ayushsagar/HDMI2USB-vmodserial/mechanical/VHDCI mating distance.jpg

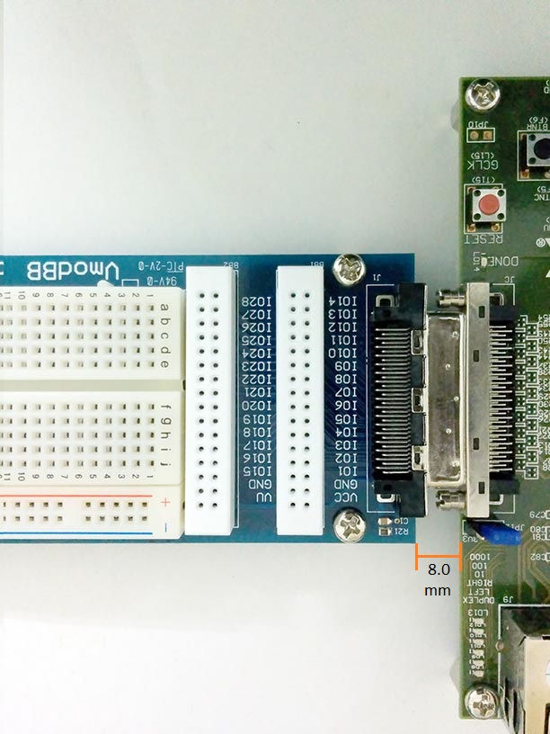
mechanical/VHDCI mating distance.jpg
