ayushsagar/HDMI2USB-vmodserial/boards/Motherboard/Motherboard.kicad_pcb

## KiCad design boards/Motherboard/Motherboard.kicad_pcb (2014-07-07)

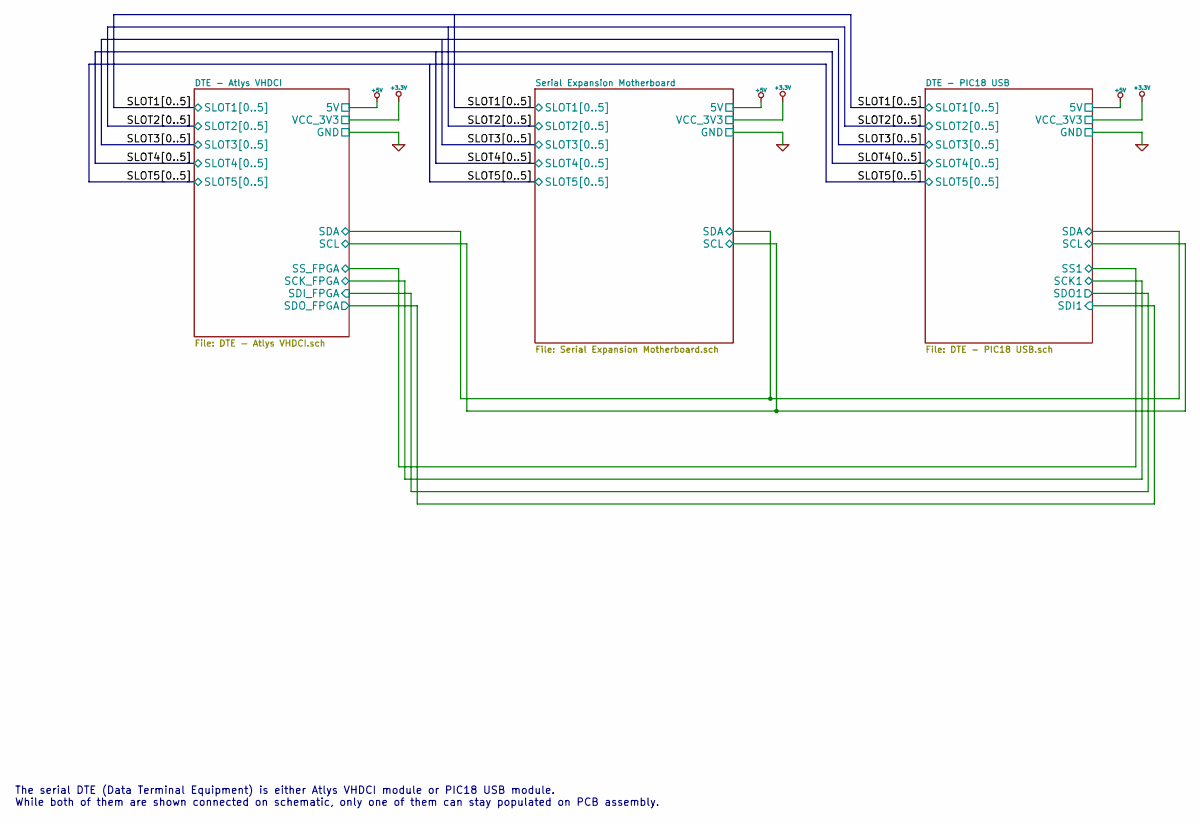
[picture p2: schematic Motherboard.sch, Serial Expansion Module and DTE interface]

Notes on the sheet:
The serial DTE (Data Terminal Equipment) is either Atlys VHDCI module or PIC18 USB module. While both of them are shown connected on schematic, only one of them can stay populated on PCB assembly.

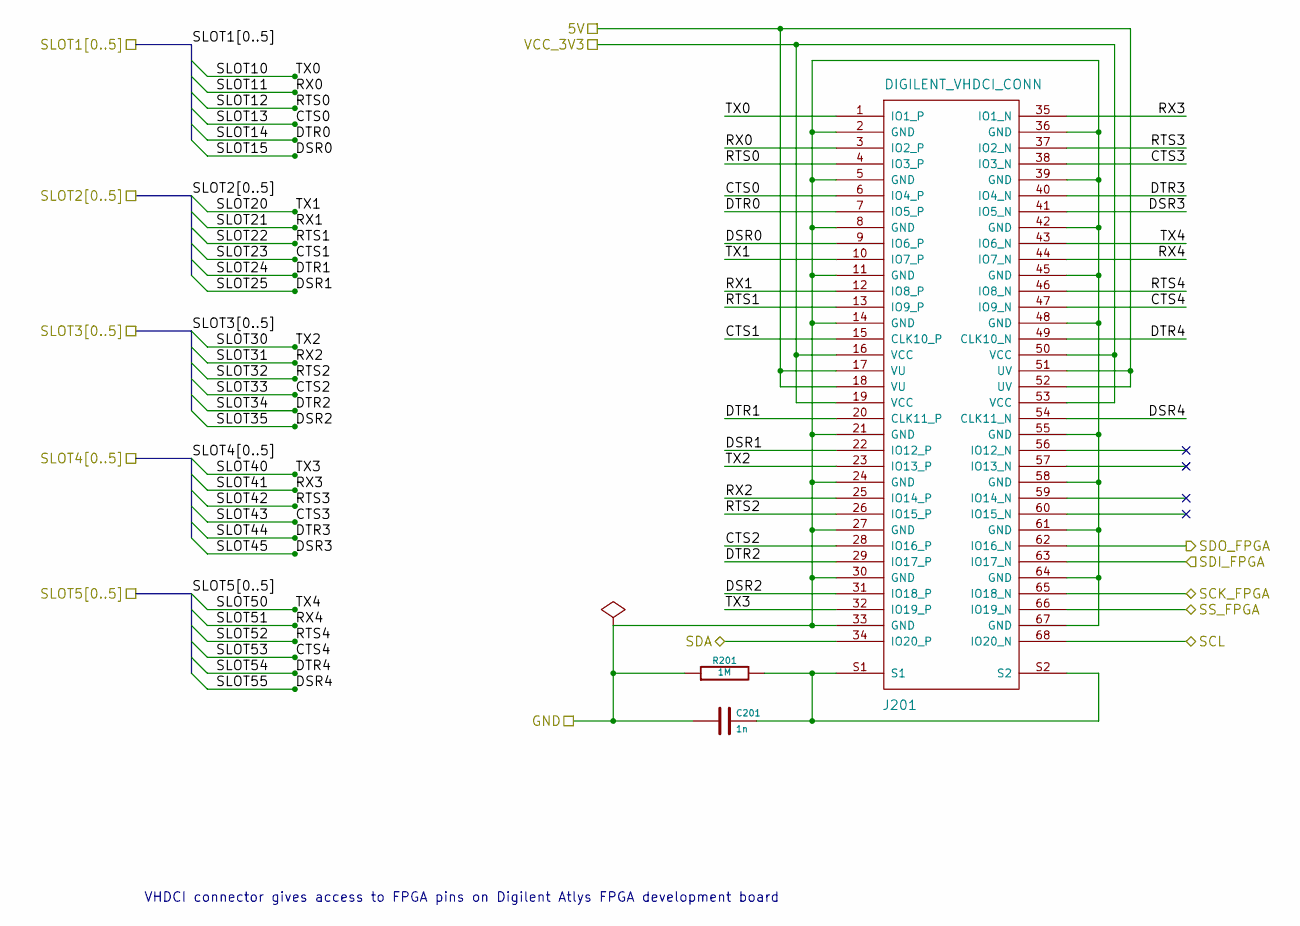
[picture p3: schematic DTE - Atlys VHDCI.sch]

Parts:
C201: 1n
J201: DIGILENT_VHDCI_CONN
R201: 1M

Connections:
+3.3V: J201.16 (VCC), J201.19 (VCC), J201.50 (VCC), J201.53 (VCC); also elsewhere on the board
+5V: J201.17 (VU), J201.18 (VU), J201.51 (UV), J201.52 (UV); also elsewhere on the board
/DTE - Atlys VHDCI/SCL: J201.68 (IO20_N); also elsewhere on the board
/DTE - Atlys VHDCI/SDA: J201.34 (IO20_P); also elsewhere on the board
/DTE - Atlys VHDCI/SDI_FPGA: J201.63 (IO17_N); also elsewhere on the board
/DTE - PIC18 USB/SCK1: J201.65 (IO18_N); also elsewhere on the board
/DTE - PIC18 USB/SDI1: J201.62 (IO16_N); also elsewhere on the board
/DTE - PIC18 USB/SS1: J201.66 (IO19_N); also elsewhere on the board
/Serial Expansion Motherboard/Data isolation/IN0_A: J201.1 (IO1_P); also elsewhere on the board
/Serial Expansion Motherboard/Data isolation/IN1_A: J201.4 (IO3_P); also elsewhere on the board
/Serial Expansion Motherboard/Data isolation/IN2_A: J201.7 (IO5_P); also elsewhere on the board
/Serial Expansion Motherboard/Data isolation/IN3_A: J201.10 (IO7_P); also elsewhere on the board
/Serial Expansion Motherboard/Data isolation/IN4_A: J201.13 (IO9_P); also elsewhere on the board
/Serial Expansion Motherboard/Data isolation/IN5_A: J201.20 (CLK11_P); also elsewhere on the board
/Serial Expansion Motherboard/Data isolation/IN6_A: J201.23 (IO13_P); also elsewhere on the board
/Serial Expansion Motherboard/Data isolation/IN7_A: J201.26 (IO15_P); also elsewhere on the board
/Serial Expansion Motherboard/Data isolation/IN8_A: J201.29 (IO17_P); also elsewhere on the board
/Serial Expansion Motherboard/Data isolation/IN9_A: J201.32 (IO19_P); also elsewhere on the board
/Serial Expansion Motherboard/Data isolation/IN10_A: J201.37 (IO2_N); also elsewhere on the board
/Serial Expansion Motherboard/Data isolation/IN11_A: J201.40 (IO4_N); also elsewhere on the board
/Serial Expansion Motherboard/Data isolation/IN12_A: J201.43 (IO6_N); also elsewhere on the board
/Serial Expansion Motherboard/Data isolation/IN13_A: J201.46 (IO8_N); also elsewhere on the board
/Serial Expansion Motherboard/Data isolation/IN14_A: J201.49 (CLK10_N); also elsewhere on the board
/Serial Expansion Motherboard/Data isolation/OUT0_A: J201.3 (IO2_P); also elsewhere on the board
/Serial Expansion Motherboard/Data isolation/OUT1_A: J201.6 (IO4_P); also elsewhere on the board
/Serial Expansion Motherboard/Data isolation/OUT2_A: J201.9 (IO6_P); also elsewhere on the board
/Serial Expansion Motherboard/Data isolation/OUT3_A: J201.12 (IO8_P); also elsewhere on the board
/Serial Expansion Motherboard/Data isolation/OUT4_A: J201.15 (CLK10_P); also elsewhere on the board
/Serial Expansion Motherboard/Data isolation/OUT5_A: J201.22 (IO12_P); also elsewhere on the board
/Serial Expansion Motherboard/Data isolation/OUT6_A: J201.25 (IO14_P); also elsewhere on the board
/Serial Expansion Motherboard/Data isolation/OUT7_A: J201.28 (IO16_P); also elsewhere on the board
/Serial Expansion Motherboard/Data isolation/OUT8_A: J201.31 (IO18_P); also elsewhere on the board
/Serial Expansion Motherboard/Data isolation/OUT9_A: J201.35 (IO1_N); also elsewhere on the board
/Serial Expansion Motherboard/Data isolation/OUT10_A: J201.38 (IO3_N); also elsewhere on the board
/Serial Expansion Motherboard/Data isolation/OUT11_A: J201.41 (IO5_N); also elsewhere on the board
/Serial Expansion Motherboard/Data isolation/OUT12_A: J201.44 (IO7_N); also elsewhere on the board
/Serial Expansion Motherboard/Data isolation/OUT13_A: J201.47 (IO9_N); also elsewhere on the board
/Serial Expansion Motherboard/Data isolation/OUT14_A: J201.54 (CLK11_N); also elsewhere on the board
GND: C201.1, J201.2 (GND), J201.5 (GND), J201.8 (GND), J201.11 (GND), J201.14 (GND), J201.21 (GND), J201.24 (GND), J201.27 (GND), J201.30 (GND), J201.33 (GND), J201.36 (GND), J201.39 (GND), J201.42 (GND), J201.45 (GND), J201.48 (GND), J201.55 (GND), J201.58 (GND), J201.61 (GND), J201.64 (GND), J201.67 (GND), R201.1; also elsewhere on the board
unnamed: C201.2, J201.S1, J201.S2, R201.2

Notes on the sheet:
VHDCI connector gives access to FPGA pins on Digilent Atlys FPGA development board

Schematic: Serial Expansion Motherboard.sch

Parts:
C401: 0.1u
R401, R402: 2.2k
R403: 50
U401: 24AA014

Connections:
+3.3V: R401.1, R402.1, R403.1; also elsewhere on the board
/DTE - Atlys VHDCI/SCL: R402.2, U401.5 (SDA); also elsewhere on the board
/DTE - Atlys VHDCI/SDA: R401.2, U401.6 (SCL); also elsewhere on the board
GND: C401.1, U401.1 (A0), U401.2 (A1), U401.3 (A2), U401.4 (GND), U401.7 (WP); also elsewhere on the board
unnamed: C401.2, R403.2, U401.8 (VCC)

Notes on the sheet:
Motherboard ID EEPROM address set to 0 (000) by shorting A0, A1 and A2 to ground.

Schematic: DTE - PIC18 USB.sch

Parts:
C613, C614: 22p
C615, C616, C618, C619, C620, C623: 0.1u
C617: 10u
C621: 4.7n
C622: 4.7u
D611, D612, D613: LED
DS11, DS12, DS21, DS22, DS31, DS32, DS41, DS42, DS51, DS52: LED
J601: USB
P601: ICSP
P602: SPI2
R619: 10K
R620, R621: 50
R640: 1M
R641: 0.47
R688, R689, R690: 680
R691: 0.10
RS11, RS12, RS21, RS22, RS31, RS32, RS41, RS42, RS51, RS52: 680
U607: PIC18F85J94
U608: AAT3221IGV-3.3-T1
X601: XTAL

Connections:
+3.3V: C616.1, C618.1, C619.1, C620.1, C623.1, P601.2, P602.1, R619.1, R691.2, U607.23 (VUSB3V3), U607.32 (VDD), U607.48 (VDD), U607.71 (VDD); also elsewhere on the board
+5V: C622.1, R641.2, U608.1 (IN), U608.3 (EN); also elsewhere on the board
/DTE - Atlys VHDCI/SCL: U607.44 (RC3/SCL1); also elsewhere on the board
/DTE - Atlys VHDCI/SDA: U607.45 (RC4/SDA1); also elsewhere on the board
/DTE - Atlys VHDCI/SDI_FPGA: U607.3 (RE1); also elsewhere on the board
/DTE - PIC18 USB/LED_P: R688.1, U607.72 (RD0)
/DTE - PIC18 USB/LED_Q: R689.1, U607.18 (RF2)
/DTE - PIC18 USB/LED_R: R690.1, U607.15 (RF5)
/DTE - PIC18 USB/PGC: P601.5, U607.52 (RB6/PGC)
/DTE - PIC18 USB/PGD: P601.4, U607.47 (RB7/PGD)
/DTE - PIC18 USB/SCK1: U607.6 (RG1); also elsewhere on the board
/DTE - PIC18 USB/SCK2_HEADER: P602.4, U607.7 (RG2)
/DTE - PIC18 USB/SDI1: U607.4 (RE0); also elsewhere on the board
/DTE - PIC18 USB/SDI2_HEADER: P602.3, U607.69 (RD1)
/DTE - PIC18 USB/SDO2_HEADER: P602.2, U607.10 (RG4)
/DTE - PIC18 USB/SLOT1_LED1: RS11.1, U607.36 (RC0)
/DTE - PIC18 USB/SLOT1_LED2: RS12.1, U607.35 (RC1)
/DTE - PIC18 USB/SLOT2_LED1: RS21.1, U607.43 (RC2)
/DTE - PIC18 USB/SLOT2_LED2: RS22.1, U607.46 (RC5)
/DTE - PIC18 USB/SLOT3_LED1: RS31.1, U607.37 (RC6)
/DTE - PIC18 USB/SLOT3_LED2: RS32.1, U607.38 (RC7)
/DTE - PIC18 USB/SLOT4_LED1: RS41.1, U607.14 (RF6)
/DTE - PIC18 USB/SLOT4_LED2: RS42.1, U607.13 (RF7)
/DTE - PIC18 USB/SLOT5_LED1: RS51.1, U607.20 (RH6)
/DTE - PIC18 USB/SLOT5_LED2: RS52.1, U607.19 (RH7)
/DTE - PIC18 USB/SS1: U607.5 (RG0); also elsewhere on the board
/DTE - PIC18 USB/SS2_HEADER: P602.5, U607.8 (RG3)
/Serial Expansion Motherboard/Data isolation/IN0_A: U607.28 (RA2); also elsewhere on the board
/Serial Expansion Motherboard/Data isolation/IN1_A: U607.34 (RA4); also elsewhere on the board
/Serial Expansion Motherboard/Data isolation/IN2_A: U607.30 (RA0); also elsewhere on the board
/Serial Expansion Motherboard/Data isolation/IN3_A: U607.55 (RB3); also elsewhere on the board
/Serial Expansion Motherboard/Data isolation/IN4_A: U607.54 (RB4); also elsewhere on the board
/Serial Expansion Motherboard/Data isolation/IN5_A: U607.58 (RB0); also elsewhere on the board
/Serial Expansion Motherboard/Data isolation/IN6_A: U607.65 (RD5/SDA2); also elsewhere on the board
/Serial Expansion Motherboard/Data isolation/IN7_A: U607.64 (RD6/SCL2); also elsewhere on the board
/Serial Expansion Motherboard/Data isolation/IN8_A: U607.68 (RD2); also elsewhere on the board
/Serial Expansion Motherboard/Data isolation/IN9_A: U607.75 (RE5); also elsewhere on the board
/Serial Expansion Motherboard/Data isolation/IN10_A: U607.74 (RE6); also elsewhere on the board
/Serial Expansion Motherboard/Data isolation/IN11_A: U607.78 (RE2); also elsewhere on the board
/Serial Expansion Motherboard/Data isolation/IN12_A: U607.1 (RH2); also elsewhere on the board
/Serial Expansion Motherboard/Data isolation/IN13_A: U607.22 (RH4); also elsewhere on the board
/Serial Expansion Motherboard/Data isolation/IN14_A: U607.79 (RH0); also elsewhere on the board
/Serial Expansion Motherboard/Data isolation/OUT0_A: U607.27 (RA3); also elsewhere on the board
/Serial Expansion Motherboard/Data isolation/OUT1_A: U607.33 (RA5); also elsewhere on the board
/Serial Expansion Motherboard/Data isolation/OUT2_A: U607.29 (RA1); also elsewhere on the board
/Serial Expansion Motherboard/Data isolation/OUT3_A: U607.56 (RB2); also elsewhere on the board
/Serial Expansion Motherboard/Data isolation/OUT4_A: U607.53 (RB5); also elsewhere on the board
/Serial Expansion Motherboard/Data isolation/OUT5_A: U607.57 (RB1); also elsewhere on the board
/Serial Expansion Motherboard/Data isolation/OUT6_A: U607.66 (RD4); also elsewhere on the board
/Serial Expansion Motherboard/Data isolation/OUT7_A: U607.63 (RD7); also elsewhere on the board
/Serial Expansion Motherboard/Data isolation/OUT8_A: U607.67 (RD3); also elsewhere on the board
/Serial Expansion Motherboard/Data isolation/OUT9_A: U607.76 (RE4); also elsewhere on the board
/Serial Expansion Motherboard/Data isolation/OUT10_A: U607.73 (RE7); also elsewhere on the board
/Serial Expansion Motherboard/Data isolation/OUT11_A: U607.77 (RE3); also elsewhere on the board
/Serial Expansion Motherboard/Data isolation/OUT12_A: U607.2 (RH3); also elsewhere on the board
/Serial Expansion Motherboard/Data isolation/OUT13_A: U607.21 (RH5); also elsewhere on the board
/Serial Expansion Motherboard/Data isolation/OUT14_A: U607.80 (RH1); also elsewhere on the board
GND: C613.1, C614.2, C615.2, C616.2, C617.2, C618.2, C619.2, C620.2, C621.2, C622.2, C623.2, D611.2 (K), D612.2 (K), D613.2 (K), DS11.2 (K), DS12.2 (K), DS21.2 (K), DS22.2 (K), DS31.2 (K), DS32.2 (K), DS41.2 (K), DS42.2 (K), DS51.2 (K), DS52.2 (K), J601.4 (GND), P601.3, P602.6, R640.2, U607.11 (VSS), U607.26 (AVSS), U607.31 (VSS), U607.51 (VSS), U607.70 (VSS), U608.2 (GND); also elsewhere on the board
unnamed: D613.1 (A), R690.2
unnamed: D612.1 (A), R689.2
unnamed: DS52.1 (A), RS52.2
unnamed: D611.1 (A), R688.2
unnamed: R621.1, U607.17 (D-/RF3)
unnamed: DS51.1 (A), RS51.2
unnamed: R620.1, U607.16 (D+/RF4)
unnamed: J601.3 (D+), R620.2
unnamed: J601.2 (D-), R621.2
unnamed: J601.1 (Vbus), R641.1
unnamed: R691.1, U608.5 (OUT)
unnamed: DS11.1 (A), RS11.2
unnamed: C621.1, J601.5 (Shield_1), J601.6 (Shield_2), R640.1
unnamed: DS12.1 (A), RS12.2
unnamed: P601.1, R619.2, U607.9 (~MCLR)
unnamed: C617.1, U607.12 (VCAP)
unnamed: C615.1, U607.25 (AVDD)
unnamed: DS41.1 (A), RS41.2
unnamed: C613.2, U607.50 (RA6/OSC1), X601.2
unnamed: C614.1, U607.49 (RA7/OSC2), X601.1
unnamed: DS42.1 (A), RS42.2
unnamed: DS32.1 (A), RS32.2
unnamed: DS31.1 (A), RS31.2
unnamed: DS22.1 (A), RS22.2
unnamed: DS21.1 (A), RS21.2

Notes on the sheet:
PIC18F85J94 MCU simulates production board for HDMI2USB as well as enables standalone operation using USB interface.
- First 4 serial ports use the 4 available hardware UARTs. Remaining serial ports need to be bitbanged - Crystal (and capactors) is optional. PIC18F85J94 has FRC internal clock, which is accurate enough to support USB 2.0 and UART.

Schematic: Data isolation.sch

Parts:
C601, C602, C603, C604, C605, C606, C607, C608, C609, C610, C611, C612: 0.1u
R601, R608, R615, R622, R629, R636, R643, R650, R657, R664, R671, R678: 50
R602, R603, R604, R605, R606, R607, R609, R610, R611, R612, R613, R614, R616, R617, R618, R623, R624, R625, R626, R627, R628, R630, R631, R632, R633, R634, R635, R637, R638, R639, R644, R645, R646, R647, R648, R649, R651, R652, R653, R654, R655, R656, R658, R659, R660, R665, R666, R667, R668, R669, R670, R672, R673, R674, R675, R676, R677, R679, R680, R681: 100
U601, U602, U603, U604: SI8660
U605, U606: SI8630/SI8660

Connections:
+3.3V: R601.1, R608.1, R615.1, R664.2, R671.2, R678.2; also elsewhere on the board
+5V_ISO: R622.2, R629.2, R636.2, R643.1, R650.1, R657.1; also elsewhere on the board
/Serial Expansion Motherboard/Data isolation/IN0_A: R602.1; also elsewhere on the board
/Serial Expansion Motherboard/Data isolation/IN0_B: R644.1; also elsewhere on the board
/Serial Expansion Motherboard/Data isolation/IN1_A: R603.1; also elsewhere on the board
/Serial Expansion Motherboard/Data isolation/IN2_A: R604.1; also elsewhere on the board
/Serial Expansion Motherboard/Data isolation/IN3_A: R605.1; also elsewhere on the board
/Serial Expansion Motherboard/Data isolation/IN3_B: R647.1; also elsewhere on the board
/Serial Expansion Motherboard/Data isolation/IN4_A: R606.1; also elsewhere on the board
/Serial Expansion Motherboard/Data isolation/IN5_A: R607.1; also elsewhere on the board
/Serial Expansion Motherboard/Data isolation/IN6_A: R609.1; also elsewhere on the board
/Serial Expansion Motherboard/Data isolation/IN6_B: R651.1; also elsewhere on the board
/Serial Expansion Motherboard/Data isolation/IN7_A: R610.1; also elsewhere on the board
/Serial Expansion Motherboard/Data isolation/IN8_A: R611.1; also elsewhere on the board
/Serial Expansion Motherboard/Data isolation/IN9_A: R612.1; also elsewhere on the board
/Serial Expansion Motherboard/Data isolation/IN9_B: R654.1; also elsewhere on the board
/Serial Expansion Motherboard/Data isolation/IN10_A: R613.1; also elsewhere on the board
/Serial Expansion Motherboard/Data isolation/IN11_A: R614.1; also elsewhere on the board
/Serial Expansion Motherboard/Data isolation/IN12_A: R616.1; also elsewhere on the board
/Serial Expansion Motherboard/Data isolation/IN12_B: R658.1; also elsewhere on the board
/Serial Expansion Motherboard/Data isolation/IN13_A: R617.1; also elsewhere on the board
/Serial Expansion Motherboard/Data isolation/IN14_A: R618.1; also elsewhere on the board
/Serial Expansion Motherboard/Data isolation/OUT0_A: R665.2; also elsewhere on the board
/Serial Expansion Motherboard/Data isolation/OUT0_B: R623.2; also elsewhere on the board
/Serial Expansion Motherboard/Data isolation/OUT1_A: R666.2; also elsewhere on the board
/Serial Expansion Motherboard/Data isolation/OUT1_B: R624.2; also elsewhere on the board
/Serial Expansion Motherboard/Data isolation/OUT2_A: R667.2; also elsewhere on the board
/Serial Expansion Motherboard/Data isolation/OUT3_A: R668.2; also elsewhere on the board
/Serial Expansion Motherboard/Data isolation/OUT3_B: R626.2; also elsewhere on the board
/Serial Expansion Motherboard/Data isolation/OUT4_A: R669.2; also elsewhere on the board
/Serial Expansion Motherboard/Data isolation/OUT4_B: R627.2; also elsewhere on the board
/Serial Expansion Motherboard/Data isolation/OUT5_A: R670.2; also elsewhere on the board
/Serial Expansion Motherboard/Data isolation/OUT6_A: R672.2; also elsewhere on the board
/Serial Expansion Motherboard/Data isolation/OUT6_B: R630.2; also elsewhere on the board
/Serial Expansion Motherboard/Data isolation/OUT7_A: R673.2; also elsewhere on the board
/Serial Expansion Motherboard/Data isolation/OUT8_A: R674.2; also elsewhere on the board
/Serial Expansion Motherboard/Data isolation/OUT9_A: R675.2; also elsewhere on the board
/Serial Expansion Motherboard/Data isolation/OUT9_B: R633.2; also elsewhere on the board
/Serial Expansion Motherboard/Data isolation/OUT10_A: R676.2; also elsewhere on the board
/Serial Expansion Motherboard/Data isolation/OUT10_B: R634.2; also elsewhere on the board
/Serial Expansion Motherboard/Data isolation/OUT11_A: R677.2; also elsewhere on the board
/Serial Expansion Motherboard/Data isolation/OUT12_A: R679.2; also elsewhere on the board
/Serial Expansion Motherboard/Data isolation/OUT12_B: R637.2; also elsewhere on the board
/Serial Expansion Motherboard/Data isolation/OUT13_A: R680.2; also elsewhere on the board
/Serial Expansion Motherboard/Data isolation/OUT13_B: R638.2; also elsewhere on the board
/Serial Expansion Motherboard/Data isolation/OUT14_A: R681.2; also elsewhere on the board
/Serial Expansion Motherboard/Daughterboard slots/CTS0_ISO: R645.1; also elsewhere on the board
/Serial Expansion Motherboard/Daughterboard slots/CTS1_ISO: R648.1; also elsewhere on the board
/Serial Expansion Motherboard/Daughterboard slots/CTS2_ISO: R631.2, R652.1; also elsewhere on the board
/Serial Expansion Motherboard/Daughterboard slots/CTS3_ISO: R655.1; also elsewhere on the board
/Serial Expansion Motherboard/Daughterboard slots/CTS4_ISO: R659.1; also elsewhere on the board
/Serial Expansion Motherboard/Daughterboard slots/DSR0_ISO: R646.1; also elsewhere on the board
/Serial Expansion Motherboard/Daughterboard slots/DSR1_ISO: R649.1; also elsewhere on the board
/Serial Expansion Motherboard/Daughterboard slots/DSR2_ISO: R653.1; also elsewhere on the board
/Serial Expansion Motherboard/Daughterboard slots/DSR3_ISO: R656.1; also elsewhere on the board
/Serial Expansion Motherboard/Daughterboard slots/DSR4_ISO: R660.1; also elsewhere on the board
/Serial Expansion Motherboard/Daughterboard slots/DTR0_ISO: R625.2; also elsewhere on the board
/Serial Expansion Motherboard/Daughterboard slots/DTR1_ISO: R628.2; also elsewhere on the board
/Serial Expansion Motherboard/Daughterboard slots/DTR2_ISO: R632.2; also elsewhere on the board
/Serial Expansion Motherboard/Daughterboard slots/DTR3_ISO: R635.2; also elsewhere on the board
/Serial Expansion Motherboard/Daughterboard slots/DTR4_ISO: R639.2; also elsewhere on the board
GND: C601.2, C602.2, C603.2, C610.2, C611.2, C612.2, U601.8 (GND1), U602.9 (GND2), U603.8 (GND1), U604.9 (GND2), U605.8 (GND1), U606.9 (GND2); also elsewhere on the board
GND_ISO: C604.2, C605.2, C606.2, C607.2, C608.2, C609.2, U601.9 (GND2), U602.8 (GND1), U603.9 (GND2), U604.8 (GND1), U605.9 (GND2), U606.8 (GND1); also elsewhere on the board
unnamed: R677.1, U604.10 (B6)
unnamed: R676.1, U604.11 (B5)
unnamed: R675.1, U604.12 (B4)
unnamed: R674.1, U604.13 (B3)
unnamed: R673.1, U604.14 (B2)
unnamed: R672.1, U604.15 (B1)
unnamed: R605.2, U601.5 (A4)
unnamed: R611.2, U603.4 (A3)
unnamed: R610.2, U603.3 (A2)
unnamed: R609.2, U603.2 (A1)
unnamed: R614.2, U603.7 (A6)
unnamed: R606.2, U601.6 (A5)
unnamed: R604.2, U601.4 (A3)
unnamed: R603.2, U601.3 (A2)
unnamed: R602.2, U601.2 (A1)
unnamed: R607.2, U601.7 (A6)
unnamed: R631.1, U603.14 (B2)
unnamed: R638.1, U605.13 (B3)
unnamed: R637.1, U605.14 (B2)
unnamed: R635.1, U603.10 (B6)
unnamed: R633.1, U603.12 (B4)
unnamed: R632.1, U603.13 (B3)
unnamed: R630.1, U603.15 (B1)
unnamed: R618.2, U605.5 (A4)
unnamed: R617.2, U605.4 (A3)
unnamed: R616.2, U605.3 (A2)
unnamed: R653.2, U604.4 (A3)
unnamed: R660.2, U606.5 (A4)
unnamed: R659.2, U606.4 (A3)
unnamed: R658.2, U606.3 (A2)
unnamed: R656.2, U604.7 (A6)
unnamed: R655.2, U604.6 (A5)
unnamed: R654.2, U604.5 (A4)
unnamed: R612.2, U603.5 (A4)
unnamed: R652.2, U604.3 (A2)
unnamed: R651.2, U604.2 (A1)
unnamed: R639.1, U605.12 (B4)
unnamed: R665.1, U602.15 (B1)
unnamed: R666.1, U602.14 (B2)
unnamed: R667.1, U602.13 (B3)
unnamed: R668.1, U602.12 (B4)
unnamed: R669.1, U602.11 (B5)
unnamed: R670.1, U602.10 (B6)
unnamed: R625.1, U601.13 (B3)
unnamed: R628.1, U601.10 (B6)
unnamed: R627.1, U601.11 (B5)
unnamed: R626.1, U601.12 (B4)
unnamed: R624.1, U601.14 (B2)
unnamed: R623.1, U601.15 (B1)
unnamed: R613.2, U603.6 (A5)
unnamed: R644.2, U602.2 (A1)
unnamed: R645.2, U602.3 (A2)
unnamed: R646.2, U602.4 (A3)
unnamed: R647.2, U602.5 (A4)
unnamed: R648.2, U602.6 (A5)
unnamed: R649.2, U602.7 (A6)
unnamed: R679.1, U606.14 (B2)
unnamed: R680.1, U606.13 (B3)
unnamed: R681.1, U606.12 (B4)
unnamed: R634.1, U603.11 (B5)
unnamed: C608.1, R650.2, U604.1 (VDD1)
unnamed: C612.1, R678.1, U606.16 (VDD2)
unnamed: C609.1, R657.2, U606.1 (VDD1)
unnamed: C607.1, R643.2, U602.1 (VDD1)
unnamed: C606.1, R636.1, U605.16 (VDD2)
unnamed: C610.1, R664.1, U602.16 (VDD2)
unnamed: C611.1, R671.1, U604.16 (VDD2)
unnamed: C604.1, R622.1, U601.16 (VDD2)
unnamed: C602.1, R608.2, U603.1 (VDD1)
unnamed: C601.1, R601.2, U601.1 (VDD1)
unnamed: C605.1, R629.1, U603.16 (VDD2)
unnamed: C603.1, R615.2, U605.1 (VDD1)

Notes on the sheet:
Postfix A refers to DTE side and postfix B refers to daughterboard side. e.g. IN12_A in an input from DTE side and OUT12_B is the output connected to daughterboard side.

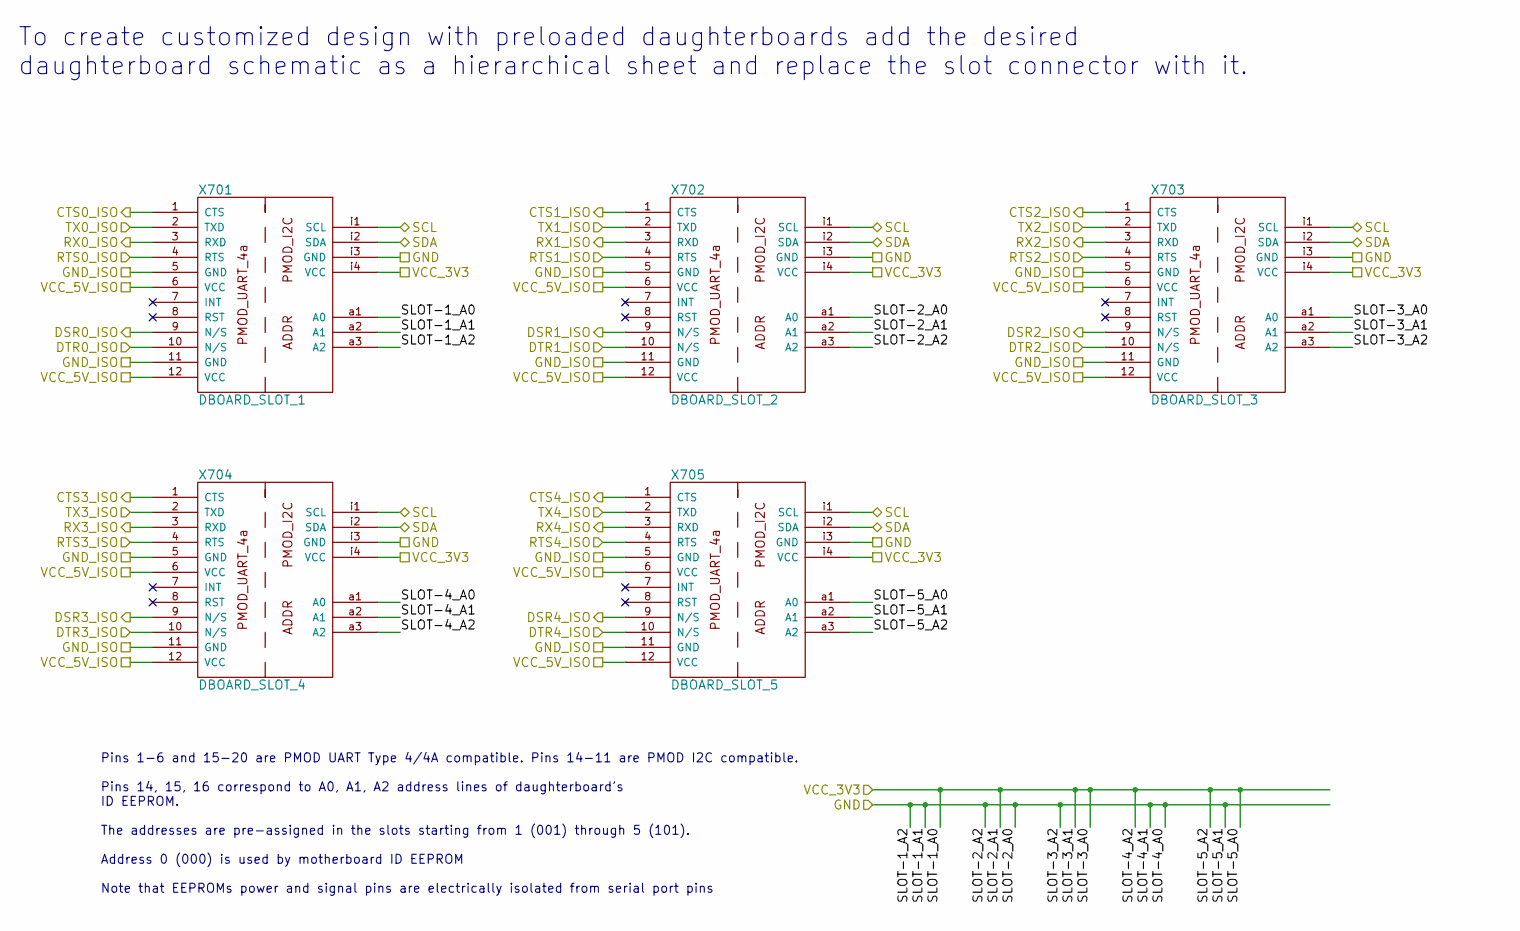
[picture p4: schematic Daughterboard slots.sch, Daughterboard interface]

Parts:
X701: DBOARD_SLOT_1
X702: DBOARD_SLOT_2
X703: DBOARD_SLOT_3
X704: DBOARD_SLOT_4
X705: DBOARD_SLOT_5

Connections:
+3.3V: X701.a1 (A0), X701.i4 (VCC), X702.a2 (A1), X702.i4 (VCC), X703.a1 (A0), X703.a2 (A1), X703.i4 (VCC), X704.a3 (A2), X704.i4 (VCC), X705.a1 (A0), X705.a3 (A2), X705.i4 (VCC); also elsewhere on the board
+5V_ISO: X701.6 (VCC), X701.12 (VCC), X702.6 (VCC), X702.12 (VCC), X703.6 (VCC), X703.12 (VCC), X704.6 (VCC), X704.12 (VCC), X705.6 (VCC), X705.12 (VCC); also elsewhere on the board
/DTE - Atlys VHDCI/SCL: X701.i2 (SDA), X702.i2 (SDA), X703.i2 (SDA), X704.i2 (SDA), X705.i2 (SDA); also elsewhere on the board
/DTE - Atlys VHDCI/SDA: X701.i1 (SCL), X702.i1 (SCL), X703.i1 (SCL), X704.i1 (SCL), X705.i1 (SCL); also elsewhere on the board
/Serial Expansion Motherboard/Data isolation/IN0_B: X701.3 (RXD); also elsewhere on the board
/Serial Expansion Motherboard/Data isolation/IN3_B: X702.3 (RXD); also elsewhere on the board
/Serial Expansion Motherboard/Data isolation/IN6_B: X703.3 (RXD); also elsewhere on the board
/Serial Expansion Motherboard/Data isolation/IN9_B: X704.3 (RXD); also elsewhere on the board
/Serial Expansion Motherboard/Data isolation/IN12_B: X705.3 (RXD); also elsewhere on the board
/Serial Expansion Motherboard/Data isolation/OUT0_B: X701.2 (TXD); also elsewhere on the board
/Serial Expansion Motherboard/Data isolation/OUT1_B: X701.4 (RTS); also elsewhere on the board
/Serial Expansion Motherboard/Data isolation/OUT3_B: X702.2 (TXD); also elsewhere on the board
/Serial Expansion Motherboard/Data isolation/OUT4_B: X702.4 (RTS); also elsewhere on the board
/Serial Expansion Motherboard/Data isolation/OUT6_B: X703.2 (TXD); also elsewhere on the board
/Serial Expansion Motherboard/Data isolation/OUT9_B: X704.2 (TXD); also elsewhere on the board
/Serial Expansion Motherboard/Data isolation/OUT10_B: X704.4 (RTS); also elsewhere on the board
/Serial Expansion Motherboard/Data isolation/OUT12_B: X705.2 (TXD); also elsewhere on the board
/Serial Expansion Motherboard/Data isolation/OUT13_B: X705.4 (RTS); also elsewhere on the board
/Serial Expansion Motherboard/Daughterboard slots/CTS0_ISO: X701.1 (CTS); also elsewhere on the board
/Serial Expansion Motherboard/Daughterboard slots/CTS1_ISO: X702.1 (CTS); also elsewhere on the board
/Serial Expansion Motherboard/Daughterboard slots/CTS2_ISO: X703.1 (CTS), X703.4 (RTS); also elsewhere on the board
/Serial Expansion Motherboard/Daughterboard slots/CTS3_ISO: X704.1 (CTS); also elsewhere on the board
/Serial Expansion Motherboard/Daughterboard slots/CTS4_ISO: X705.1 (CTS); also elsewhere on the board
/Serial Expansion Motherboard/Daughterboard slots/DSR0_ISO: X701.9 (N/S); also elsewhere on the board
/Serial Expansion Motherboard/Daughterboard slots/DSR1_ISO: X702.9 (N/S); also elsewhere on the board
/Serial Expansion Motherboard/Daughterboard slots/DSR2_ISO: X703.9 (N/S); also elsewhere on the board
/Serial Expansion Motherboard/Daughterboard slots/DSR3_ISO: X704.9 (N/S); also elsewhere on the board
/Serial Expansion Motherboard/Daughterboard slots/DSR4_ISO: X705.9 (N/S); also elsewhere on the board
/Serial Expansion Motherboard/Daughterboard slots/DTR0_ISO: X701.10 (N/S); also elsewhere on the board
/Serial Expansion Motherboard/Daughterboard slots/DTR1_ISO: X702.10 (N/S); also elsewhere on the board
/Serial Expansion Motherboard/Daughterboard slots/DTR2_ISO: X703.10 (N/S); also elsewhere on the board
/Serial Expansion Motherboard/Daughterboard slots/DTR3_ISO: X704.10 (N/S); also elsewhere on the board
/Serial Expansion Motherboard/Daughterboard slots/DTR4_ISO: X705.10 (N/S); also elsewhere on the board
GND: X701.a2 (A1), X701.a3 (A2), X701.i3 (GND), X702.a1 (A0), X702.a3 (A2), X702.i3 (GND), X703.a3 (A2), X703.i3 (GND), X704.a1 (A0), X704.a2 (A1), X704.i3 (GND), X705.a2 (A1), X705.i3 (GND); also elsewhere on the board
GND_ISO: X701.5 (GND), X701.11 (GND), X702.5 (GND), X702.11 (GND), X703.5 (GND), X703.11 (GND), X704.5 (GND), X704.11 (GND), X705.5 (GND), X705.11 (GND); also elsewhere on the board

Notes on the sheet:
To create customized design with preloaded daughterboards add the desired daughterboard schematic as a hierarchical sheet and replace the slot connector with it.
Pins 1-6 and 15-20 are PMOD UART Type 4/4A compatible. Pins 14-11 are PMOD I2C compatible. Pins 14, 15, 16 correspond to A0, A1, A2 address lines of daughterboard's ID EEPROM. The addresses are pre-assigned in the slots starting from 1 (001) through 5 (101). Address 0 (000) is used by motherboard I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

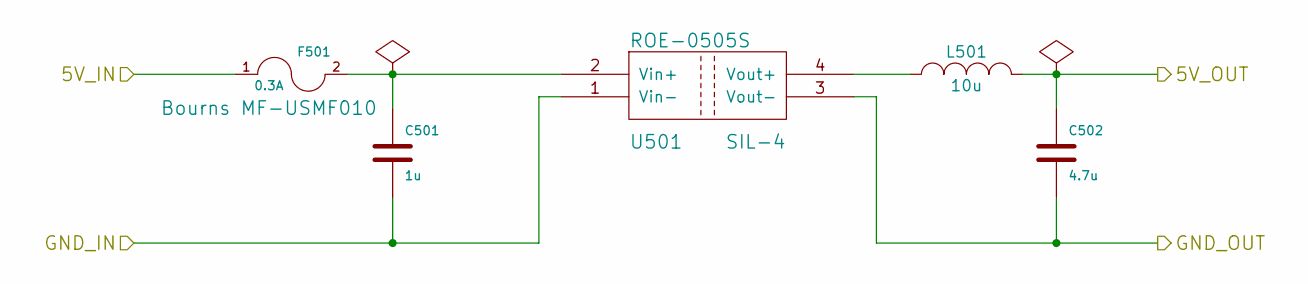
[picture p5: schematic Power isolation.sch]

Parts:
C501: 1u
C502: 4.7u
F501: 0.3A
L501: 10u
U501: ROE-0505S; SIL-4

Connections:
+5V: F501.1; also elsewhere on the board
+5V_ISO: C502.1, L501.2; also elsewhere on the board
GND: C501.2, U501.1 (Vin-); also elsewhere on the board
GND_ISO: C502.2, U501.3 (Vout-); also elsewhere on the board
unnamed: L501.1, U501.4 (Vout+)
unnamed: C501.1, F501.2, U501.2 (Vin+)

Board: 2 copper layers, 161 parts (104 on the bottom side), 190 nets, no tracks yet.

Other parts of the board:
Atlys_screw_hole: VAL**; Atlys_screw_hole
Atlys_screw_hole#2, Atlys_screw_hole#3, Atlys_screw_hole#4: VAL**; Atlys_screw_hole
