ayushsagar/HDMI2USB-vmodserial/boards/RS232C daughterboard/RS232C daughterboard.kicad_pcb

## KiCad design boards/RS232C daughterboard/RS232C daughterboard.kicad_pcb (2014-07-05)

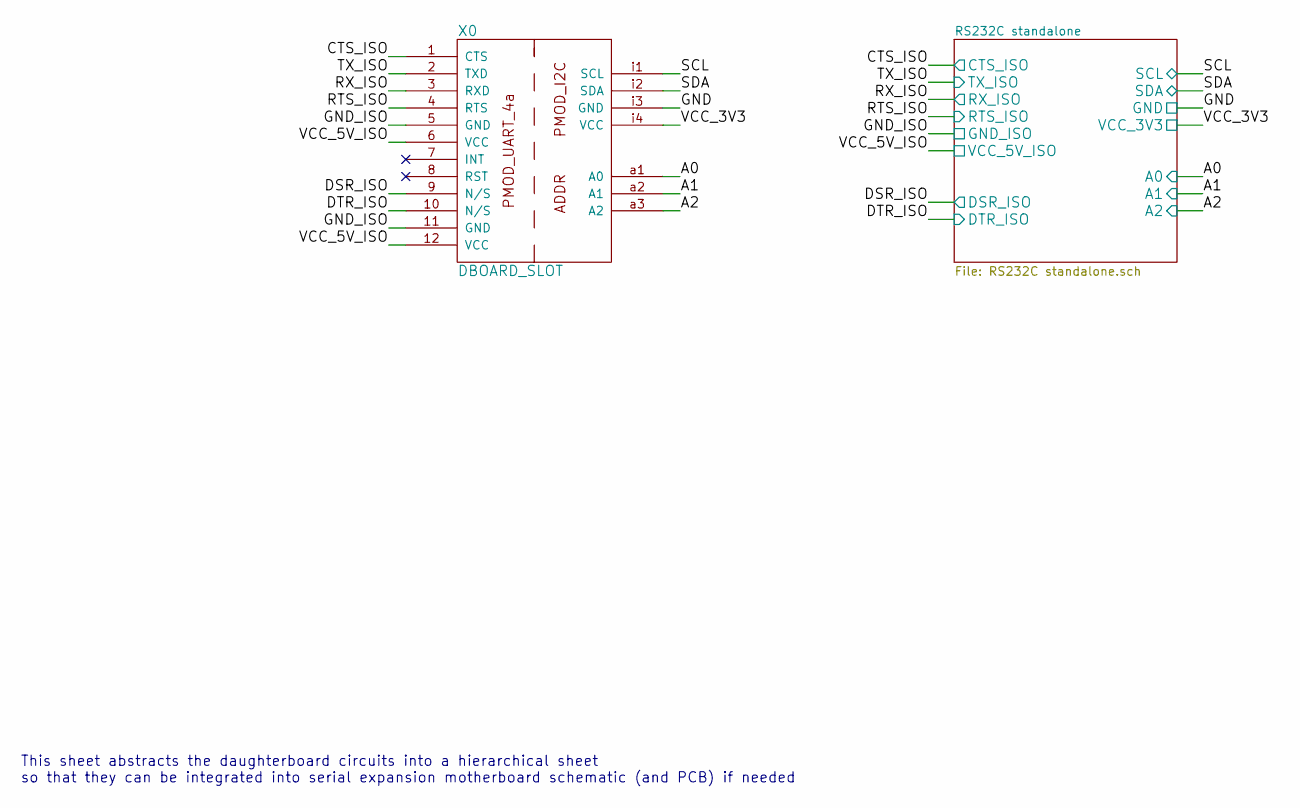
[picture p6: schematic RS232C daughterboard.sch]

Parts:
X0: DBOARD_SLOT

Connections:
unnamed: X0.5 (GND), X0.11 (GND)
unnamed: X0.6 (VCC), X0.12 (VCC)

Notes on the sheet:
This sheet abstracts the daughterboard circuits into a hierarchical sheet so that they can be integrated into serial expansion motherboard schematic (and PCB) if needed

Schematic: RS232C standalone.sch

Parts:
C201, C207, C208, C209, C210, C211, C212: 0.1u
D202: LED
J202: DB9
R202: 820
R203: 50
U202: 24AA014
U203: ISL83387E

Connections:
/RS232C standalone/A0: U202.1 (A0); also elsewhere on the board
/RS232C standalone/A1: U202.2 (A1); also elsewhere on the board
/RS232C standalone/A2: U202.3 (A2); also elsewhere on the board
/RS232C standalone/CTS_ISO: U203.13 (R2OUT); also elsewhere on the board
/RS232C standalone/C_CTS: J202.8, U203.17 (R2IN)
/RS232C standalone/C_DSR: J202.6, U203.16 (R3IN)
/RS232C standalone/C_DTR: J202.4, U203.19 (T3OUT)
/RS232C standalone/C_RTS: J202.7, U203.20 (T2OUT)
/RS232C standalone/C_RX: J202.2, U203.18 (R1IN)
/RS232C standalone/C_TX: J202.3, U203.21 (T1OUT)
/RS232C standalone/DSR_ISO: U203.12 (R3OUT); also elsewhere on the board
/RS232C standalone/DTR_ISO: U203.10 (T3IN); also elsewhere on the board
/RS232C standalone/GND: C201.1, U202.4 (GND), U202.7 (WP); also elsewhere on the board
/RS232C standalone/GND_ISO: C209.2, C210.2, C211.2, C212.2, D202.2 (K), J202.5, U203.11 (FORCEON), U203.22 (GND); also elsewhere on the board
/RS232C standalone/RTS_ISO: U203.8 (T2IN); also elsewhere on the board
/RS232C standalone/RX_ISO: U203.14 (R1OUT); also elsewhere on the board
/RS232C standalone/SCL: U202.6 (SCL); also elsewhere on the board
/RS232C standalone/SDA: U202.5 (SDA); also elsewhere on the board
/RS232C standalone/TX_ISO: U203.7 (T1IN); also elsewhere on the board
/RS232C standalone/VCC_3V3: R203.1; also elsewhere on the board
/RS232C standalone/VCC_5V_ISO: C211.1, C212.1, U203.15 (VL), U203.23 (VCC), U203.24 (~FORCEOFF); also elsewhere on the board
unnamed: C207.1, U203.1 (C1+)
unnamed: C207.2, U203.3 (C1-)
unnamed: C208.1, U203.4 (C2+)
unnamed: D202.1 (A), R202.1
unnamed: C208.2, U203.5 (C2-)
unnamed: R202.2, U203.9 (~INVALID)
unnamed: C210.1, U203.2 (V+)
unnamed: C209.1, U203.6 (V-)
unnamed: C201.2, R203.2, U202.8 (VCC)

Notes on the sheet:
DTE Serial DB9 pinout: 1 DCD <-- Data Carrier Detect 2 RXD <-- Receive Data 3 TXD --> Transmit Data 4 DTR --> Data Terminal Ready 5 GND --- System Ground 6 DSR <-- Data Set Ready 7 RTS --> Request to Send 8 CTS <-- Clear to Send 9 RI <-- Ring Indicator

Board: 2 copper layers, 14 parts (0 on the bottom side), 30 nets, no tracks yet.

Other parts of the board:
P0: HEADER; pin_array_10x2

Their connections:
/RS232C standalone/A0: P0.8; also elsewhere on the board
/RS232C standalone/A1: P0.9; also elsewhere on the board
/RS232C standalone/A2: P0.10; also elsewhere on the board
/RS232C standalone/CTS_ISO: P0.1; also elsewhere on the board
/RS232C standalone/DSR_ISO: P0.18; also elsewhere on the board
/RS232C standalone/DTR_ISO: P0.17; also elsewhere on the board
/RS232C standalone/GND: P0.12; also elsewhere on the board
/RS232C standalone/GND_ISO: P0.5, P0.16; also elsewhere on the board
/RS232C standalone/RTS_ISO: P0.4; also elsewhere on the board
/RS232C standalone/RX_ISO: P0.3; also elsewhere on the board
/RS232C standalone/SCL: P0.14; also elsewhere on the board
/RS232C standalone/SDA: P0.13; also elsewhere on the board
/RS232C standalone/TX_ISO: P0.2; also elsewhere on the board
/RS232C standalone/VCC_3V3: P0.11; also elsewhere on the board
/RS232C standalone/VCC_5V_ISO: P0.6; also elsewhere on the board
