ayushsagar/HDMI2USB-vmodserial/boards/MIDI daughterboard/MIDI daughterboard.kicad_pcb

## KiCad design boards/MIDI daughterboard/MIDI daughterboard.kicad_pcb (2014-07-05)

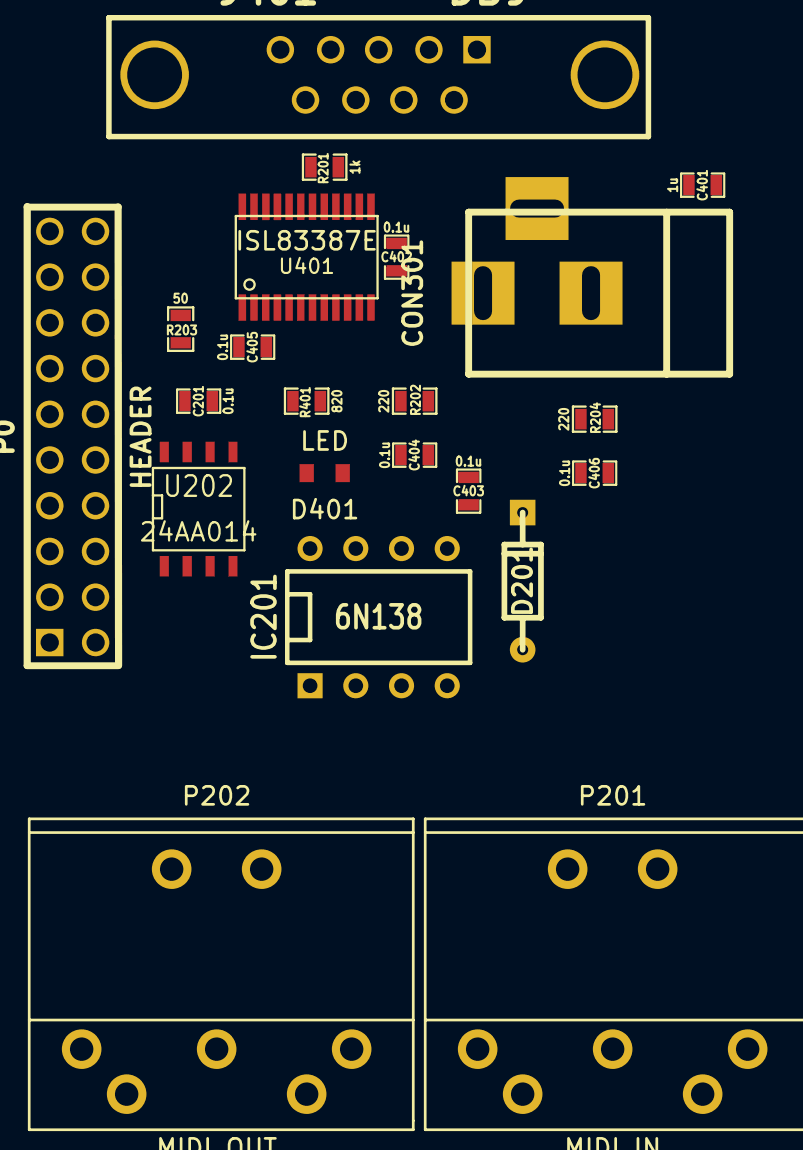
[picture p7: board MIDI daughterboard.kicad_pcb from above]

Board: 2 copper layers, 22 parts (0 on the bottom side), 30 nets, no tracks yet.

Parts:
C201, C402, C403, C404, C405, C406: 0.1u; SM0603_Capa
C401: 1u; SM0603_Capa
CON301: BARREL_JACK
D201: 1N914; DO-35
D401: LED; Vishay_SMD_MiniLED
IC201: 6N138; DIP-8__300
J401: DB9; DB9FD
P0: HEADER; pin_array_10x2
P201: MIDI_IN; CUI_SDS-50J
P202: MIDI_OUT; CUI_SDS-50J
R201: 1k; SM0603_Resistor
R202, R204: 220; SM0603_Resistor
R203: 50; SM0603_Resistor
R401: 820; SM0603_Resistor
U202: 24AA014; SO8N
U401: ISL83387E; tssop-24

Connections:
/MIDI standalone/A0: P0.8, U202.1
/MIDI standalone/A1: P0.9, U202.2
/MIDI standalone/A2: P0.10, U202.3
/MIDI standalone/GND: C201.1, P0.12, U202.4, U202.7
/MIDI standalone/GND_ISO: C401.2, C402.2, C403.2, C404.2, CON301.2, D401.2, IC201.5, J401.5, P0.5, P0.16, P202.2, U401.11, U401.22
/MIDI standalone/RS232 adapter block/A_CTS: J401.8, U401.20
/MIDI standalone/RS232 adapter block/A_DSR: J401.6, U401.19
/MIDI standalone/RS232 adapter block/A_DTR: J401.4, U401.16
/MIDI standalone/RS232 adapter block/A_RTS: J401.7, U401.17
/MIDI standalone/RS232 adapter block/A_RX: J401.2, U401.21
/MIDI standalone/RS232 adapter block/A_TX: J401.3, U401.18
/MIDI standalone/RX_ISO: IC201.6, P0.3, R201.2, U401.7
/MIDI standalone/SCL: P0.14, U202.6
/MIDI standalone/SDA: P0.13, U202.5
/MIDI standalone/TX_ISO: P0.2, P202.5, U401.14
/MIDI standalone/VCC_3V3: P0.11, R203.1
/MIDI standalone/VCC_5V_ISO: C401.1, C402.1, CON301.1, IC201.8, P0.6, R201.1, R204.1, U401.15, U401.23, U401.24
unnamed: P202.4, R204.2
unnamed: P201.5, R202.2
unnamed: D201.1, IC201.3, R202.1
unnamed: D201.2, IC201.2, P201.4
unnamed: C201.2, R203.2, U202.8
unnamed: D401.1, R401.1
unnamed: R401.2, U401.9
unnamed: C406.2, U401.5
unnamed: C404.1, U401.6
unnamed: C405.1, U401.1
unnamed: C405.2, U401.3
unnamed: C406.1, U401.4
unnamed: C403.1, U401.2
