ayushsagar/HDMI2USB-vmodserial/(commit log)

2014-06-21 Added mechanical data and restructured folders
    [Serial Expansion Board.sch]
2014-06-22 Done most of top level design
    [DTE - Atlys VHDCI.sch, DTE - PIC18 USB interface.sch, DTE - PIC18 USB.sch, Data isolation.sch, Daughterboard.sch, Daughterboards.sch, ID controller.sch, Main.sch]
2014-06-22 Completed data and power isolation sheets
    [$Main.sch, DTE - Atlys VHDCI.sch, DTE - PIC18 USB.sch, Data isolation.sch, Daughterboards.sch, ID controller.sch, Power isolation.sch, Serial Expansion Motherboard.sch]
2014-06-22 ID controller complete, bypass caps added in data isolation
    [$Main.sch, DTE - Atlys VHDCI.sch, DTE - PIC18 USB.sch, Data isolation.sch, Daughterboards.sch, ID controller.sch, Main.sch, Power isolation.sch]
2014-06-23 ID detection changed from RC to EEPROM based, D.board pinout changed, PIC18F85J94 added
    [DTE - Atlys VHDCI.sch, DTE - PIC18 USB.sch, Data isolation.sch, Daughterboards.sch, Main.sch, Power isolation.sch, Serial Expansion Motherboard.sch]
2014-06-23 Added NC pin to D.board pinout for better elec. isolation
    [Daughterboards.sch]
2014-06-23 Completed PIC 18 USB sheet; Motherboard schematic done
    [DTE - Atlys VHDCI.sch, DTE - PIC18 USB.sch, Data isolation.sch, Daughterboards.sch, Main.sch, Power isolation.sch, Serial Expansion Motherboard.sch]
2014-06-23 Netlist DRC pass - fixed pins types, incorrect connections, added PWRFLAGS
    [DTE - Atlys VHDCI.sch, DTE - PIC18 USB.sch, Data isolation.sch, Daughterboards.sch, Power isolation.sch, Serial Expansion Motherboard.sch]
2014-06-23 Added ISL83387E, deleted discarded daughterboard.sch
    [Daughterboard.sch]
2014-06-23 Changed project name Main to Motherboard to avoid confusion with independent daughterboard projects to be created
    [Motherboard.sch]
2014-06-23 Fixed major flaw in autodetection circuit - daughterboard header pinout changed to set address of ROMs depending on slot
    [DTE - Atlys VHDCI.sch, DTE - PIC18 USB.sch, Data isolation.sch, Daughterboards.sch, Motherboard.sch, Power isolation.sch, Serial Expansion Motherboard.sch]
2014-06-23 Updated notes and sheet names
    [DTE - Atlys VHDCI.sch, DTE - PIC18 USB.sch, Data isolation.sch, Daughterboards.sch, Motherboard.sch, Power isolation.sch, Serial Expansion Motherboard.sch]
2014-06-23 Fixed Csmall not showing up in some versions of kicad. Fixed C308
    [DTE - Atlys VHDCI.sch, DTE - PIC18 USB.sch, Data isolation.sch, Daughterboards.sch, Motherboard.sch, Power isolation.sch, Serial Expansion Motherboard.sch]
2014-06-23 Removed ID controller.sch
    [DTE - PIC18 USB.sch, ID controller.sch]
2014-06-24 fixed untracked files
    [DTE - Atlys VHDCI.sch, DTE - PIC18 USB.sch, Data isolation.sch, Daughterboards.sch, Motherboard.sch, Power isolation.sch, Serial Expansion Motherboard.sch]
2014-06-24 Changed UART debug connector from 2 pin to 4 pin and annotated unannotated parts
    [DTE - PIC18 USB.sch]
2014-06-24 Renamed Daughterboard.sch to Daughterboard slots.sch to avoid confusion
    [Daughterboard slots.sch, Serial Expansion Motherboard.sch]
2014-06-24 Added note about A and B postfix to Data isolation sheet
    [Data isolation.sch]
2014-06-25 Changed Motherboard.sch to show bus connection
    [DTE - Atlys VHDCI.sch, DTE - PIC18 USB.sch, Data isolation.sch, Daughterboard slots.sch, Motherboard.sch, Power isolation.sch, Serial Expansion Motherboard.sch]
2014-06-25 Organized file structure
    [DTE - Atlys VHDCI.sch, DTE - PIC18 USB interface.sch, DTE - PIC18 USB.sch, Data isolation.sch, Daughterboard slots.sch, Motherboard.sch, Power isolation.sch, Serial Expansion Motherboard.sch]
2014-06-25 Changed pins in PIC18F85J94.lib to mention 2nd I2C port
2014-06-25 Added LED mech drawing for LED daughterboard
2014-06-25 Major changes in DTE PIC18 USB sheet
    [DTE - PIC18 USB.sch]
2014-06-25 Fixed DRC errors in DTE PIC18 USB sheet, changed VCC names to include voltages
    [DTE - Atlys VHDCI.sch, DTE - PIC18 USB.sch, Data isolation.sch, Power isolation.sch, Serial Expansion Motherboard.sch]
2014-06-25 Fixed power pin and port names to include voltages
    [DTE - Atlys VHDCI.sch, DTE - PIC18 USB.sch, Daughterboard slots.sch, Motherboard.sch, Serial Expansion Motherboard.sch]
2014-06-25 Changed folder board to boards
    [DTE - Atlys VHDCI.sch, DTE - PIC18 USB interface.sch, DTE - PIC18 USB.sch, Data isolation.sch, Daughterboard slots.sch, Motherboard.sch, Power isolation.sch, Serial Expansion Motherboard.sch]
2014-06-25 Updated file structure to accommodate daughterboard projects
    [DTE - Atlys VHDCI.sch, DTE - PIC18 USB interface.sch, DTE - PIC18 USB.sch, Data isolation.sch, Daughterboard slots.sch, Motherboard.sch, Power isolation.sch, Serial Expansion Motherboard.sch]
2014-06-25 Changed I2C pins on PIC18F85J94 to use free Port G
    [DTE - PIC18 USB.sch]
2014-06-25 Changed power pin/port names
    [Daughterboard slots.sch, Serial Expansion Motherboard.sch]
2014-06-25 Changed daughterboard slots to support Digilent PMOD and changed label names
    [DTE - Atlys VHDCI.sch, DTE - PIC18 USB.sch, Data isolation.sch, Daughterboard slots.sch, Motherboard.sch, Power isolation.sch, Serial Expansion Motherboard.sch]
2014-06-25 Added PMOD specs
    [Daughterboard slots.sch]
2014-06-26 Started blank RS232C dboard schematic and renamed folder
    [RS232C daughterboard.sch]
2014-06-26 Annotated parts in dboard slots sheet
    [DTE - Atlys VHDCI.sch, DTE - PIC18 USB.sch, Data isolation.sch, Daughterboard slots.sch, Motherboard.sch, Power isolation.sch, Serial Expansion Motherboard.sch]
2014-06-26 Filled in RS232 dboard, changed GPIO24 to GPIO16 board
    [RS232C daughterboard.sch, RS232C standalone.sch]
2014-06-26 Completed RS232C daughterboard
    [RS232C daughterboard.sch, RS232C standalone.sch]
2014-06-26 Fixed errors in RS232C daughterboard, ERC passed
    [RS232C daughterboard.sch, RS232C standalone.sch]
2014-06-26 Improved main sheet of RS232C daughterboard
    [RS232C daughterboard.sch]
2014-06-26 Added currentlimiting resistor to RS232 dboard eeprom
    [RS232C standalone.sch]
2014-06-26 Updated PIC18F USB pin mapping, connections to be made
    [DTE - PIC18 USB.sch]
2014-06-26 Updated templates of all dboards with commonalities of all dboards
    [DMX512 daughterboard.sch, DMX512 standalone.sch, DTE - PIC18 USB.sch, GPIO-16 DB25 daughterboard.sch, GPIO-16 DB25 standalone.sch, GPIO-8 daughterboard.sch, GPIO-8 standalone.sch, IR daughterboard.sch]
2014-06-26 Updated PIC18 USB sheet, top sheet connections remaining
    [DTE - PIC18 USB.sch]
2014-06-26 GPIO-8 daughterboard done; create reusable PIC16F GPIO sheet
    [GPIO-8 daughterboard.sch, GPIO-8 standalone.sch, PIC-GPIO8.sch]
2014-06-26 IR daughterboard done
    [IR daughterboard.sch, IR standalone.sch, PIC-GPIO8.sch]
2014-06-30 Done RS422/485 Daughterboard
    [RS422 RJ-45 daughterboard.sch, RS422 RJ-45 standalone.sch]
2014-06-30 RS422 board done
    [$RS422 RJ-45 standalone.sch]
2014-06-30 Add common folder, and common input block for dboards
    [RS232_adapter_block.sch]
2014-06-30 Fix label in common input block
    [RS232_adapter_block.sch]
2014-06-30 Remove PWR_FLAG from VCC in RS232 adapter block (earlier called common input block)
    [RS232_adapter_block.sch]
2014-06-30 Update RS422 RJ-45 dboard to use RS232 adapter common block
    [$RS422 RJ-45 standalone.sch, RS422 RJ-45 daughterboard.sch, RS422 RJ-45 standalone.sch]
2014-06-30 Change to 5 serial port; Connect Atlys and PIC18F SPI; Entire schematic updated
    [DTE - Atlys VHDCI.sch, DTE - PIC18 USB.sch, Data isolation.sch, Daughterboard slots.sch, Motherboard.sch, Power isolation.sch, Serial Expansion Motherboard.sch]
2014-06-30 Add missing dpdt_slide-switch files
2014-06-30 Change all serial connections to use BUS
    [DTE - Atlys VHDCI.sch, DTE - PIC18 USB.sch, Data isolation.sch, Daughterboard slots.sch, Motherboard.sch, Serial Expansion Motherboard.sch]
2014-06-30 Fixed bus errors
    [DTE - Atlys VHDCI.sch, DTE - PIC18 USB.sch, Motherboard.sch, Serial Expansion Motherboard.sch]
2014-06-30 Fixed Power isolation block accidently deleted in e0792
    [DTE - Atlys VHDCI.sch, DTE - PIC18 USB.sch, Data isolation.sch, Daughterboard slots.sch, Motherboard.sch, Power isolation.sch, Serial Expansion Motherboard.sch]
2014-06-30 Divded bus among ports. Fixes #10
    [DTE - Atlys VHDCI.sch, DTE - PIC18 USB.sch, Daughterboard slots.sch, Motherboard.sch, Serial Expansion Motherboard.sch]
2014-06-30 Converted power hierarchical pins to passive
    [DTE - Atlys VHDCI.sch, DTE - PIC18 USB.sch, Serial Expansion Motherboard.sch]
2014-07-01 Updated daughterboard header pinout in all sheets to be PMOD UART 4/4A compatible
    [DMX512 daughterboard.sch, DMX512 standalone.sch, DTE - Atlys VHDCI.sch, DTE - PIC18 USB.sch, Data isolation.sch, Daughterboard slots.sch, GPIO-16 DB25 daughterboard.sch, GPIO-16 DB25 standalone.sch]
2014-07-01 Updated LED references in PIC18FUSB. Fixes #19
    [DTE - PIC18 USB.sch]
2014-07-01 Removed RS232 adapter input module from RS232C daughterboard
    [RS232C standalone.sch]
2014-07-01 Updated GPIO8 dboard to use RS232 adapter block; Changed power hierarchy pin in RS232_adapter_block and PIC-GPIO8 sheets as passive type
    [GPIO-8 daughterboard.sch, GPIO-8 standalone.sch, PIC-GPIO8.sch, RS232_adapter_block.sch]
2014-07-01 Updated IR dboard to use RS232 adapter block; Changed power hierarchy pins in RS232 adapter block and GPIO 8 sheet as passive type
    [IR daughterboard.sch, IR standalone.sch, PIC-GPIO8.sch, RS232_adapter_block.sch]
2014-07-01 Updated IR dboard to use RS232 adapter block; Changed power hierarchy pins in RS232 adapter block and GPIO 8 sheet as passive type; Reannotated sheet
    [IR standalone.sch, PIC-GPIO8.sch]
2014-07-02 Rearranged EEPROM pins in dboard slot pinout to be compatible with PMOD I2C interface
    [DMX512 daughterboard.sch, DMX512 standalone.sch, DTE - Atlys VHDCI.sch, DTE - PIC18 USB.sch, Data isolation.sch, Daughterboard slots.sch, GPIO-16 DB25 daughterboard.sch, GPIO-16 DB25 standalone.sch]
2014-07-02 Changed hierarchical pins in mboard top sheet to be tristate/BiDi instead of passive
    [Motherboard.sch]
2014-07-02 Changed LED resistor references in PIC18F USB sheet
    [DTE - PIC18 USB.sch]
2014-07-02 Placed power ports on top sheet of motherboard. Fixes #21
    [Motherboard.sch]
2014-07-02 Updated RS232 adapter block to include DC jack, changed power pins to passive; Changed power pins on RS422 dboard sheet to passive
    [RS232_adapter_block.sch, RS422 RJ-45 daughterboard.sch, RS422 RJ-45 standalone.sch]
2014-07-02 Connected SPI and I2C with wires in mboard top sheet
    [Motherboard.sch]
2014-07-02 Changed C622 to use std value MLCC
    [DTE - PIC18 USB.sch]
2014-07-02 Added 10x2 pin array module
2014-07-02 Fixed 10x2 pin array module
2014-07-02 Fixed again, 10x2 pin array module
2014-07-03 Added shield pins and fixed holes in VHDCI module
2014-07-03 Created footprint for Vishay SMD MiniLED
2014-07-03 Updated gitignore to ignore kicad_pcb-bak
2014-07-03 Started motherboard PCB
    [Motherboard.kicad_pcb]
2014-07-03 Motherboard PCB components all spread out
    [Motherboard.kicad_pcb]
2014-07-03 Reviewed RS232C schematics; Updated R202; Changed power hierarchical pins to passive
    [RS232C daughterboard.sch, RS232C standalone.sch]
2014-07-03 Shifted PIC-GPIO8.sch to _common and updated related schematics
    [GPIO-8 standalone.sch, IR standalone.sch, PIC-GPIO8.sch]
2014-07-03 Done DMX512 daughterboard schematics
    [DMX512 daughterboard.sch, DMX512 standalone.sch, PIC-GPIO8.sch, RS232_adapter_block.sch]
2014-07-03 Added bypass capacitor to EEPROM in DMX512 dboard
    [DMX512 daughterboard.sch, DMX512 standalone.sch, PIC-GPIO8.sch]
2014-07-03 Fixed invalid reference to PIC-GPIO8.sch
    [GPIO-8 standalone.sch]
2014-07-03 Added bypass capacitor to EEPROM in GPIO8 dboard and made cosmetic changes
    [GPIO-8 daughterboard.sch, GPIO-8 standalone.sch, PIC-GPIO8.sch, RS232_adapter_block.sch]
2014-07-03 Added bypass capacitor to EEPROM in RS232C dboard
    [RS232C standalone.sch]
2014-07-03 Added bypass capacitor to EEPROM in IR dboard and made cosmetic changes
    [IR daughterboard.sch, IR standalone.sch, PIC-GPIO8.sch, RS232_adapter_block.sch]
2014-07-03 Added bypass capacitor to EEPROM in GPIO16 DB25 dboard and cleaned template
    [GPIO-16 DB25 daughterboard.sch, GPIO-16 DB25 standalone.sch]
2014-07-03 Added bypass capacitor to EEPROM in LED dboard and cleaned template
    [LED daughterboard.sch, LED standalone.sch]
2014-07-03 Added bypass capacitor to EEPROM in MIDI dboard template and cleaned template
    [MIDI daughterboard.sch, MIDI standalone.sch]
2014-07-03 Added bypass capacitor to EEPROM in RS422 dboard
    [RS232_adapter_block.sch, RS422 RJ-45 daughterboard.sch, RS422 RJ-45 standalone.sch]
2014-07-03 Done MIDI daughterboard; Changed bypass capacitor in RS232_adapter_block from 0.1u to 1.0u
    [MIDI daughterboard.sch, MIDI standalone.sch, RS232_adapter_block.sch]
2014-07-03 Changed pinout conf headers in RS422 dboard and changed hierarchical pin types
    [RS232_adapter_block.sch, RS422 RJ-45 daughterboard.sch, RS422 RJ-45 standalone.sch]
2014-07-03 Changed hierarchical pin types in RS232C dboard
    [RS232C daughterboard.sch]
2014-07-03 Changed LED resistor values to 1.5k in PIC18 USB schematic
    [DTE - Atlys VHDCI.sch, DTE - PIC18 USB.sch, Data isolation.sch, Daughterboard slots.sch, Motherboard.sch, Power isolation.sch, Serial Expansion Motherboard.sch]
2014-07-03 Removed DB9 pinout note in GPIO-8 dboard
    [GPIO-8 standalone.sch, PIC-GPIO8.sch, RS232_adapter_block.sch]
2014-07-03 Removed DB9 pinout note in DMX512 dboard
    [DMX512 standalone.sch, PIC-GPIO8.sch, RS232_adapter_block.sch]
2014-07-03 Removed DB9 pinout note in IR dboard
    [IR standalone.sch, PIC-GPIO8.sch, RS232_adapter_block.sch]
2014-07-03 GPIO16 DB25 Daughterboard done
    [GPIO-16 DB25 daughterboard.sch, GPIO-16 DB25 standalone.sch, PIC-GPIO8.sch]
2014-07-03 Added DB25 pinout note to GPIO16 DB25 Daughterboard
    [GPIO-16 DB25 standalone.sch]
2014-07-03 Changed LED resistor in RS232C dboard to 820R to be 3.3-5V compatible
    [RS232C standalone.sch]
2014-07-03 Run CvPcb on RS232C dboard. Completed footprint association
2014-07-03 Started RS232C dboard pcb. Spread out all components
    [RS232C daughterboard.kicad_pcb]
2014-07-03 Changed header to 10x2 pin array from DIP20 in RS232C dboard
    [RS232C daughterboard.kicad_pcb]
2014-07-04 Changed LED resistor to 680R in PIC18 USB
    [DTE - Atlys VHDCI.sch, DTE - PIC18 USB.sch, Data isolation.sch, Daughterboard slots.sch, Motherboard.sch, Power isolation.sch, Serial Expansion Motherboard.sch]
2014-07-04 Changed LED resistor values to 820R
    [GPIO-8 daughterboard.sch, GPIO-8 standalone.sch]
2014-07-04 Added 10x1 pin array footprint
2014-07-04 Done CvPcb and started GPIO-8 daughterboard PCB, laid out components
    [GPIO-8 daughterboard.kicad_pcb]
2014-07-04 Added RJ45 footprint
2014-07-04 Added 8x1 pin array, DPDT switch footprints and drawing
2014-07-04 Added shield pin 9 in FCI RJ45 module
2014-07-04 Started RS422 dboard PCB. Laid out components
    [RS422 RJ-45 daughterboard.kicad_pcb]
2014-07-04 Done CvPcb on DMX512 dboard, started PCB, laid out components
    [DMX512 daughterboard.kicad_pcb]
2014-07-05 Updated TRS connectors in IR daughterboard
    [IR daughterboard.sch, IR standalone.sch]
2014-07-05 Fixed wrong footprint associated to DB9 on IR daughterboard
2014-07-05 Started PCB for IR daughterboard, laid out components
    [IR daughterboard.kicad_pcb]
2014-07-05 Started PCB for MIDI dboard and laid out components
    [MIDI daughterboard.kicad_pcb]
2014-07-05 Updated daughterboard base mechanical specification for separated I2C header
2014-07-05 Created daughterboard slot schematic component
2014-07-05 Updated motherboard schematic to use new dboard_slot component
    [DTE - Atlys VHDCI.sch, DTE - PIC18 USB.sch, Data isolation.sch, Daughterboard slots.sch, Motherboard.sch, Power isolation.sch, Serial Expansion Motherboard.sch]
2014-07-05 Updated RS232C dboard to use new dboard_slot component
    [RS232C daughterboard.kicad_pcb, RS232C daughterboard.sch, RS232C standalone.sch]
2014-07-05 Updated RS422 dboard to use new dboard_slot component
    [RS422 RJ-45 daughterboard.sch, RS422 RJ-45 standalone.sch]
2014-07-05 Updated MIDI dboard to use new dboard_slot component
    [MIDI daughterboard.sch, MIDI standalone.sch]
2014-07-05 Updated GPIO-8 dboard to use new dboard_slot component
    [GPIO-8 daughterboard.sch, GPIO-8 standalone.sch]
2014-07-05 Updated GPIO-16 dboard to use new dboard_slot component
    [GPIO-16 DB25 daughterboard.sch, GPIO-16 DB25 standalone.sch]
2014-07-05 Updated IR dboard to use new dboard_slot component
    [IR daughterboard.sch, IR standalone.sch]
2014-07-05 Updated DMX512 dboard to use new dboard_slot component
    [DMX512 daughterboard.sch, DMX512 standalone.sch]
2014-07-05 Updated LED dboard to use new dboard_slot component
    [LED daughterboard.sch, LED standalone.sch]
2014-07-05 Created daughterboard slot module dboard_slot.mod
2014-07-05 Fixed slot addressing error
    [Daughterboard slots.sch]
2014-07-05 Changed U606 value to include Si8630
    [Data isolation.sch]
2014-07-06 Added boundaries to VHDCI footprint
2014-07-07 Components coagulated and arranged in motherboard PCB
    [DTE - Atlys VHDCI.sch, Motherboard.kicad_pcb, Motherboard.sch, Power isolation.sch, Serial Expansion Motherboard.sch]
2014-07-07 Edited motherboard PCB, changed canvas to A4
    [Motherboard.kicad_pcb]
2014-07-07 Motherboard PCB components arranged within 2 slot area, drawn a dashed line
    [Motherboard.kicad_pcb]
2014-07-08 Flipped U602, U604, U606 in data isolation sheet to make it less confusing, fixed typo in note written below
    [DTE - Atlys VHDCI.sch, DTE - PIC18 USB.sch, Data isolation.sch, Daughterboard slots.sch, Motherboard.sch, Power isolation.sch, Serial Expansion Motherboard.sch]
2014-07-08 Changed power pins to passive in data isolation sheet
    [Data isolation.sch, Serial Expansion Motherboard.sch]
